vladbelous/mcp16251-tiny412-boost/img/layout_back.png

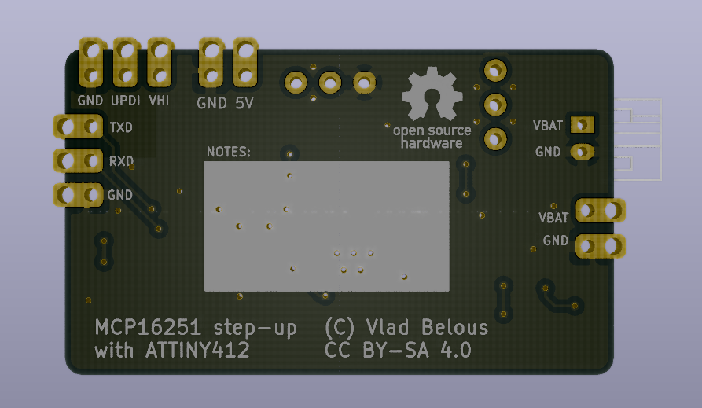
img/layout_back.png
