vladbelous/mcp16251-tiny412-boost/img/schematic.pdf

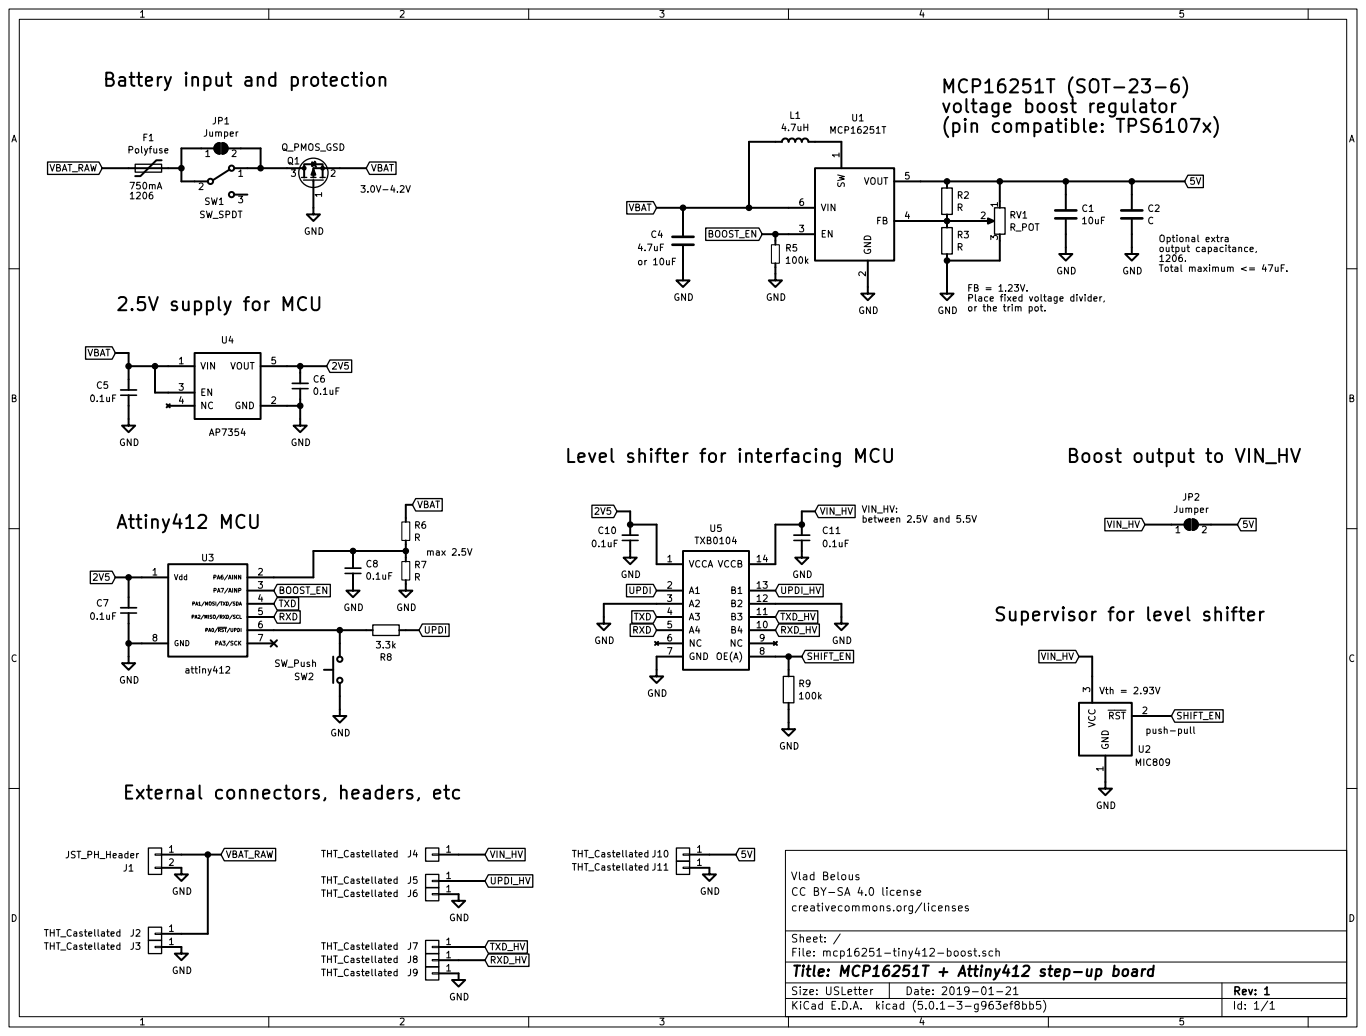
[picture p5: page 1]

2 EN 3 FB 4 VOUT 5 VIN 6 U1 MCP16251T C4

output capacitance, 1206. Total maximum <= 47uF. C2 C GND

FB = 1.23V. Place fixed voltage divider,

RXD Level shifter for interfacing MCU

File: mcp16251-tiny412-boost.sch Sheet: / creativecommons.org/licenses CC BY-SA 4.0 license Vlad Belous

Id: 1/1 Title: MCP16251T + Attiny412 step-up board
