vladbelous/mcp16251-tiny412-boost/mcp16251-tiny412-boost.kicad_pcb

## KiCad design mcp16251-tiny412-boost.kicad_pcb (2019-03-02)

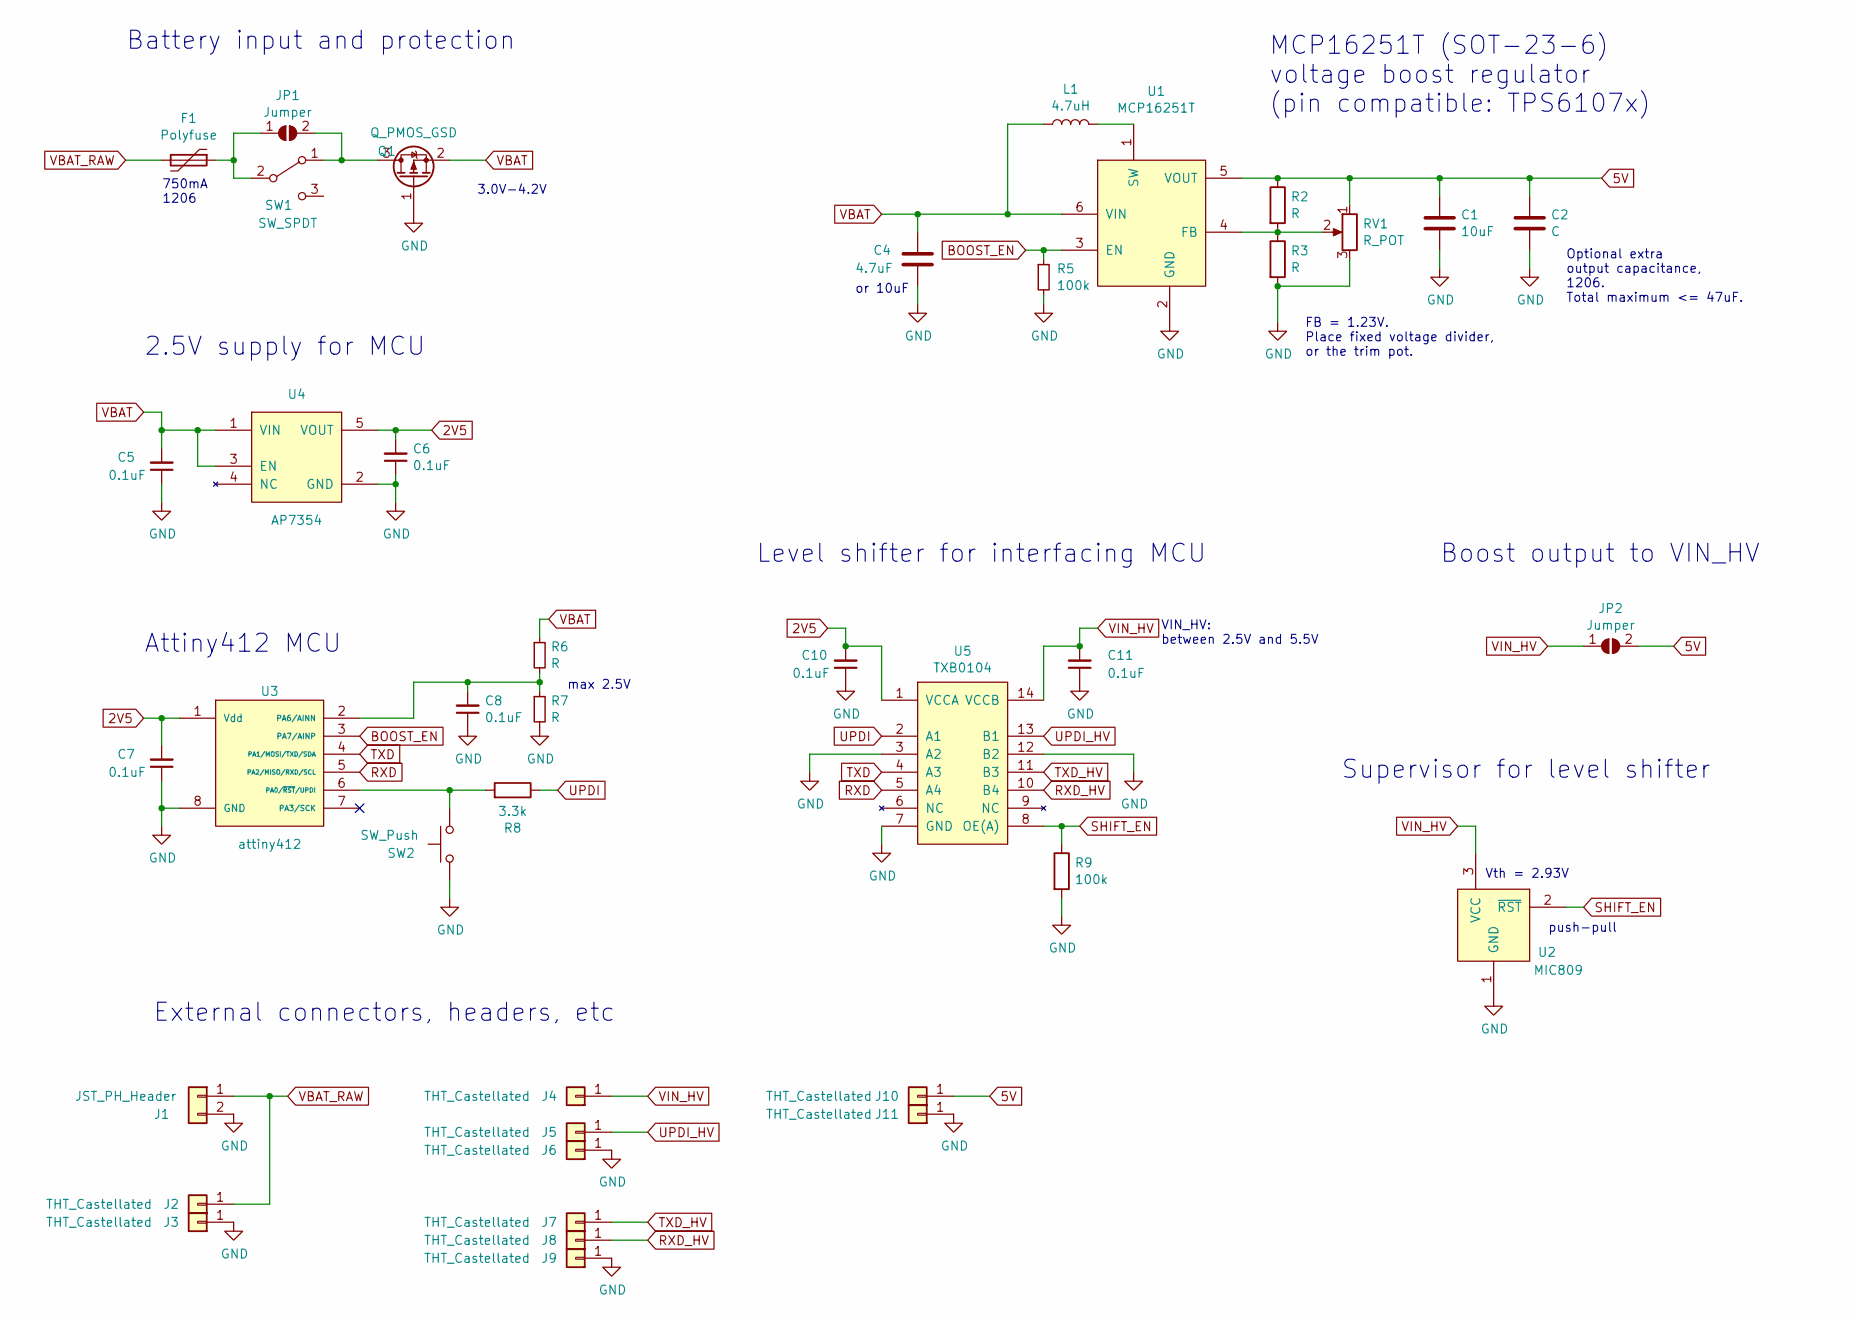
[picture p6: schematic mcp16251-tiny412-boost.sch, MCP16251T + Attiny412 step-up board]

Parts:
C1: 10uF; 1206_HS
C2: C; 1206_HS
C4: 4.7uF; 1206_HS
C5, C6, C7, C8, C10, C11: 0.1uF; 0805_HS
F1: Polyfuse; 1206_HS
J1: JST_PH_Header; JST_PH_S2B-PH-K_02x2.00mm_Angled
J2, J3, J4, J5, J6, J7, J8, J9, J10, J11: THT_Castellated; Conn_01x01_cast
JP1, JP2: Jumper; 0805_HS
L1: 4.7uH; L_Taiyo-Yuden_NR-S-40xx_HS
Q1: Q_PMOS_GSD; SOT-23_HS
R2, R3, R6, R7: R; 0805_HS
R5, R9: 100k; 0805_HS
R8: 3.3k; 0805_HS
RV1: R_POT; Conn_01x03_small
SW1: SW_SPDT; Conn_01x03_small
SW2: SW_Push; SW_SPST_PUSH_6mm_3mm
U1: MCP16251T; SOT-23-6_HS
U2: MIC809; SOT-23_HS
U3: attiny412; SOIC-8_3.9x4.9mm_Pitch1.27_HSmm
U4: AP7354; SOT-23-5_HS
U5: TXB0104; SOIC-14_3.9x8.7mm_Pitch1.27mm_HS

Connections:
2V5: C6.2, C7.2, C10.2, U3.1 (Vdd), U4.5 (VOUT), U5.1 (VCCA)
5V: C1.1, C2.1, J10.1, JP2.2 (B), R2.1, RV1.1, U1.5 (VOUT)
BOOST_EN: R5.1, U1.3 (EN), U3.3 (PA7/AINP)
GND: C1.2, C2.2, C4.2, C5.1, C6.1, C7.1, C8.1, C10.1, C11.1, J1.2, J3.1, J6.1, J9.1, J11.1, Q1.1 (G), R3.2, R5.2, R7.2, R9.2, RV1.3, SW2.2, U1.2 (GND), U2.1 (GND), U3.8 (GND), U4.2 (GND), U5.3 (A2), U5.7 (GND), U5.12 (B2)
unnamed: C8.2, R6.2, R7.1, U3.2 (PA6/AINN)
unnamed: F1.1, JP1.1 (A), SW1.2 (B)
unnamed: JP1.2 (B), Q1.3 (D), SW1.1 (A)
unnamed: L1.2, U1.1 (SW)
unnamed: R2.2, R3.1, RV1.2, U1.4 (FB)
unnamed: R8.2, SW2.1, U3.6 (PA0/~RST~/UPDI)
RXD: U3.5 (PA2/MISO/RXD/SCL), U5.5 (A4)
RXD_HV: J8.1, U5.10 (B4)
SHIFT_EN: R9.1, U2.2 (~RST), U5.8 (OE(A))
TXD: U3.4 (PA1/MOSI/TXD/SDA), U5.4 (A3)
TXD_HV: J7.1, U5.11 (B3)
UPDI: R8.1, U5.2 (A1)
UPDI_HV: J5.1, U5.13 (B1)
VBAT: C4.1, C5.2, L1.1, Q1.2 (S), R6.1, U1.6 (VIN), U4.1 (VIN), U4.3 (EN)
VBAT_RAW: F1.2, J1.1, J2.1
VIN_HV: C11.2, J4.1, JP2.1 (A), U2.3 (VCC), U5.14 (VCCB)

Notes on the sheet:
Battery input and protection
FB = 1.23V. Place fixed voltage divider, or the trim pot.
MCP16251T (SOT-23-6) voltage boost regulator (pin compatible: TPS6107x)
or 10uF
Optional extra output capacitance, 1206. Total maximum <= 47uF.
Vth = 2.93V
750mA 1206
push-pull
3.0V-4.2V
max 2.5V
2.5V supply for MCU
Attiny412 MCU
External connectors, headers, etc
Level shifter for interfacing MCU
VIN_HV: between 2.5V and 5.5V
Boost output to VIN_HV
Supervisor for level shifter

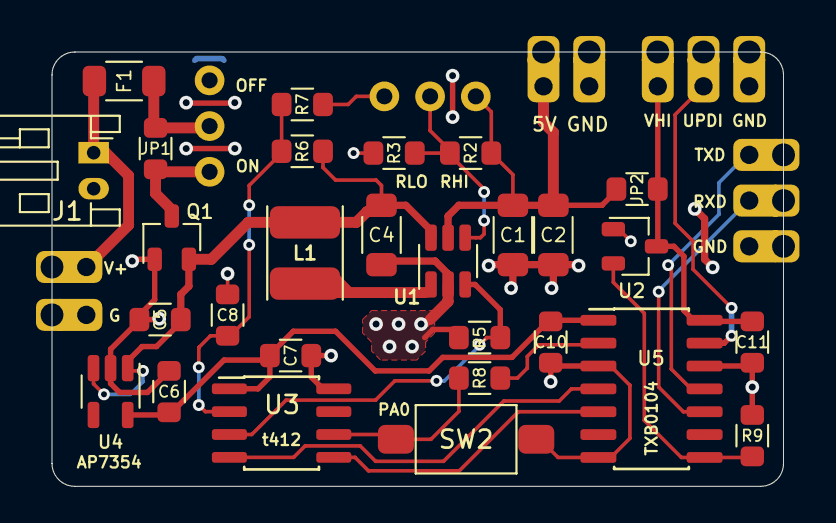
[picture p7: board mcp16251-tiny412-boost.kicad_pcb from above]

Board: 2 copper layers, 40.6 x 24.1 mm, 40 parts (0 on the bottom side), 20 nets.
