vladbelous/mcp16251-tiny412-boost/(commit log)

2019-01-22 Major components
    [mcp16251-tiny412-boost.sch]
2019-02-19 Further schematic work
    [mcp16251-tiny412-boost.sch]
2019-02-19 Add logic level shifter TXB104
    [mcp16251-tiny412-boost.kicad_pcb, mcp16251-tiny412-boost.sch]
2019-02-19 Initial complete design, needs proof-reading
    [mcp16251-tiny412-boost.sch]
2019-02-25 Annotate schematic, prepare footprints
    [mcp16251-tiny412-boost.sch]
2019-02-25 Prepare for layout
    [mcp16251-tiny412-boost.kicad_pcb]
2019-02-26 Approx boost circuit arrangement
    [mcp16251-tiny412-boost.kicad_pcb]
2019-02-27 Complete layout candidate, no routing
    [mcp16251-tiny412-boost.kicad_pcb]
2019-03-01 Step-up converter sub-circuit wiring
    [mcp16251-tiny412-boost.kicad_pcb]
2019-03-01 Complete routing, pending verification
    [mcp16251-tiny412-boost.kicad_pcb]
2019-03-02 Check layout, add silkscreen
    [mcp16251-tiny412-boost.kicad_pcb]
